dfourer/eHandPan/ESP32/doc/analyse/20250417_delai_piezzo_son/image1.jpeg

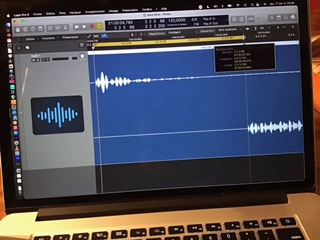
ESP32/doc/analyse/20250417_delai_piezzo_son/image1.jpeg
