dfourer/eHandPan/ESP32/doc/analyse/20260203_v2.1/20260203_123001.jpg

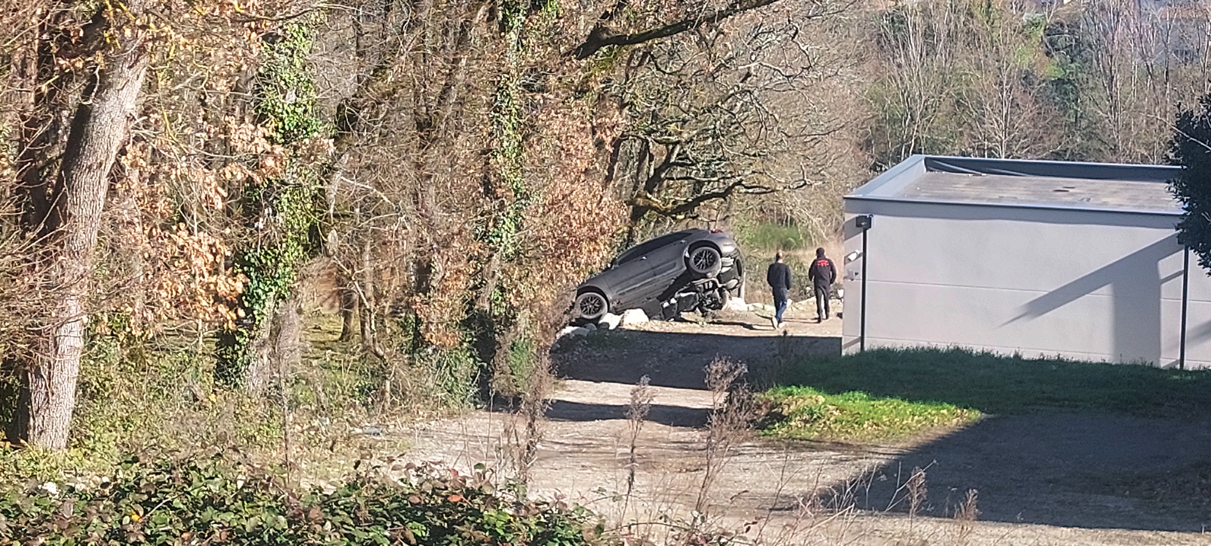
ESP32/doc/analyse/20260203_v2.1/20260203_123001.jpg
