dfourer/eHandPan/ESP32/version.md

# Liste des versions de RecupPan

| Version | Date | Comment |
| :---: | :----: | --- |
| v1.3 | xxx | Midi Send | 
| v1.2 | avril | multi-thread & détection |
| v1.1 | 03/03/25 | Retour du stage de février | 
| v1.0 | 20/02/25 | Version livrée aux 1er stagiares | 
| v0.1 | 20/12/24 | Version initiale |  

## v1.4
- joue les notes reçu en MIDI par le séquenceur + LED
- métronome staand-alone
- corrige un pb de fichier MiDI non uploadable depuis un tél GOOGLE PIXEL
- corrige un pb de bagotement à la connexion WIFI depuis un tél SAMSUNG S9

## v1.3
- envoi les notes en MIDI sur le 2ème port UDB

## v1.1 
- Page d'accueil
    - accès à l'écran de  réglages des seuils de piezzo
    - accès à l'écran de mise à jour de firmware
- Ecran Configuration : séparé 2 écrans : 
    - réglage des seuils 
    - réglage des paramètres généraux
- Réglage des seuils de piezzo 
    - Accès à la page d'accueil
    - Séparation en 2 saladiers, 
    - Possibilité d'incrémenter en +-50 depuis porta
    - Possibilité de reset tous les seuils d'un coup par saladier
- Gestion des trilles
- Demo : version Imagine en intégralité avec les trilles
- Start / stop mis sous forme de bouton image

## v1.0
- LED violette pour les frappes en mode livre (plutôt que alternance bleu/rouge)
- tempo de 500ms au démarrage pour laisser le temps aux chips de s'initialiser (limite les démarrages KO)

## v0.3
- tbd1
- tbd2

## v0.2
- tbd1
- tbd2

## v0.1
- 1ère Version draft
