dfourer/eHandPan/ESP32/doc/doc.md

# ESP32
- https://lastminuteengineers.com/esp32-basics-adc/
- https://scienceprog.com/using-current-limiting-resistors-on-avr-io-pins/
- https://espressif-docs.readthedocs-hosted.com/projects/arduino-esp32/en/latest/api/adc.html

# I2S
-   http://www.xtronical.com/I2SAudio

# MUX 
-  https://www.carnetdumaker.net/articles/utiliser-un-multiplexeur-analogique-cd4067b-avec-une-carte-arduino-genuino/
- https://deepbluembedded.com/arduino-cd74hc4067-analog-multiplexer-library-code/
- https://www.google.com/url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

# HTML
-  https://www.scriptol.fr/html5/progress.php
-  https://developer.mozilla.org/fr/docs/Web/HTML/Element/progress
- https://medium.com/@predragdavidovic10/native-dual-range-slider-html-css-javascript-91e778134816
- https://w3collective.com/double-range-slider-html-css-js/

#  MIDI
-  MIDI online parser : https://tonejs.github.io/Midi/

# piezzo
- https://forum.arduino.cc/t/piezo-on-cd74hc4067-problem/151307
- https://forum.arduino.cc/t/gate-for-piezoelectric-sensor/979572/8
- https://forums.futura-sciences.com/electronique/816828-connecter-un-piezo-de-facon-pro-a-un-p.html
- https://electronics.stackexchange.com/questions/576299/piezo-connected-to-esp32-why-doesnt-it-kill-the-input
- https://github.com/Projectslearner/esp32-piezoelectric-sensor
- https://forums.parallax.com/discussion/65336/zener-diode-for-piezo-sensor-voltage-regulator
- https://forum.arduino.cc/t/how-to-wire-a-piezo-as-an-impact-sensor/901726

# ZENER
- https://electronics.stackexchange.com/questions/595859/zener-diode-as-voltage-limiter-in-a-voltage-divider

https://musicfromouterspace.com/analogsynth_new/SOUNDLABMINISYNTH/drumtrigger/drumtrigger.html

# AOP
e 741 en a 1 aop le lm328 en a 2 et le lm324 en a 4.
Je n'ai pas mis de résistance en sortie de l'AOP , il serait préférable de mettre 1k par exemple du coté du µp.

sn74hc241n

https://github.com/Projectslearner/esp32-piezoelectric-sensor

https://ecampus.heh.be/pluginfile.php/81025/course/overviewfiles/aop_montages2020long.pdf

https://forum.allaboutcircuits.com/threads/how-to-limit-90v-from-piezo-film-sensor-to-3-3-3v.40821/

https://forum.arduino.cc/t/piezo-on-cd74hc4067-problem/151307

https://forums.parallax.com/discussion/65336/zener-diode-for-piezo-sensor-voltage-regulator

https://ecampus.heh.be/pluginfile.php/81025/course/overviewfiles/aop_montages2020long.pdf

https://forum.allaboutcircuits.com/threads/how-to-limit-90v-from-piezo-film-sensor-to-3-3-3v.40821/

https://electronics.stackexchange.com/questions/595859/zener-diode-as-voltage-limiter-in-a-voltage-divider

https://forums.futura-sciences.com/electronique/816828-connecter-un-piezo-de-facon-pro-a-un-p.html

https://musicfromouterspace.com/analogsynth_new/SOUNDLABMINISYNTH/drumtrigger/drumtrigger.html

e 741 en a 1 aop le lm328 en a 2 et le lm324 en a 4.
Je n'ai pas mis de résistance en sortie de l'AOP , il serait préférable de mettre 1k par exemple du coté du µp.

sn74hc241n

https://ecampus.heh.be/pluginfile.php/81025/course/overviewfiles/aop_montages2020long.pdf

https://forum.arduino.cc/t/how-to-wire-a-piezo-as-an-impact-sensor/901726

https://community.element14.com/technologies/test-and-measurement/b/blog/posts/piezo-disk-as-vibration-sensor-input-buffer-and-filter

# FreeROS
https://www.freertos.org/
https://docs.espressif.com/projects/esp-idf/en/v4.3-rc/esp32/api-guides/freertos-smp.html
https://esp32.com/viewtopic.php?t=12121

# GIT
git rm -rf --cached .
git add .
