dfourer/eHandPan/ESP32/doc/analyse/20260203_v2.1/v2.1.pptx

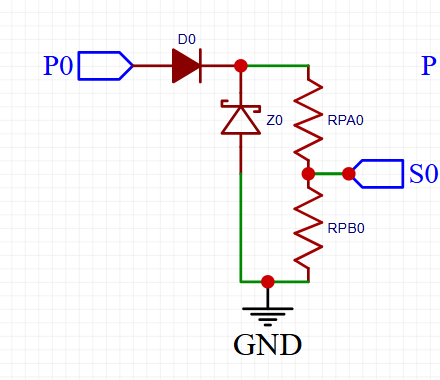
[picture p3: figure]

1N4006

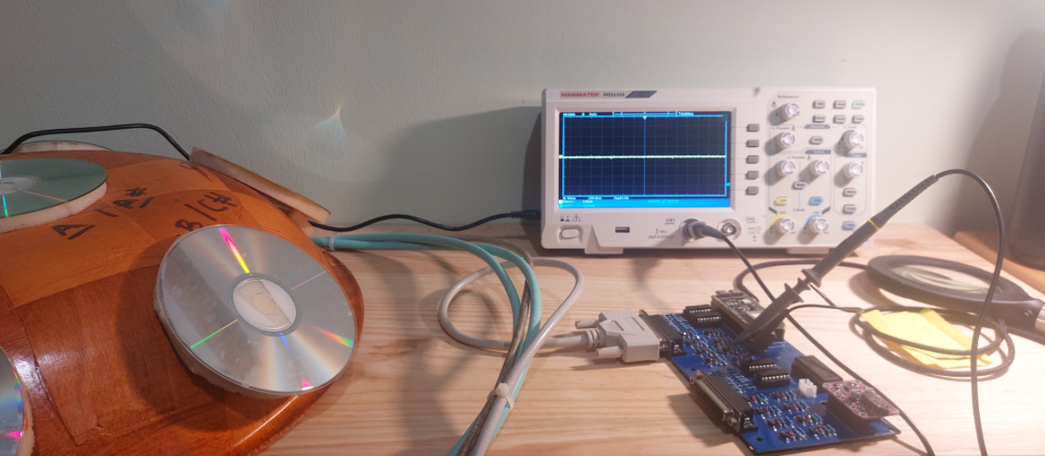
[picture p4: figure]

1Mo

1N4745A

Vz=16V

200ko

## Slide 2

Mesures à la sortie du piezzo (P0)

Signal 5-6V

2V / DIV

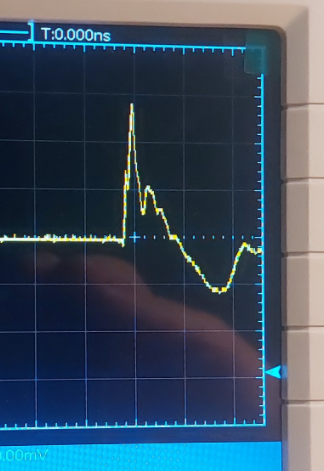
[picture p5: figure]
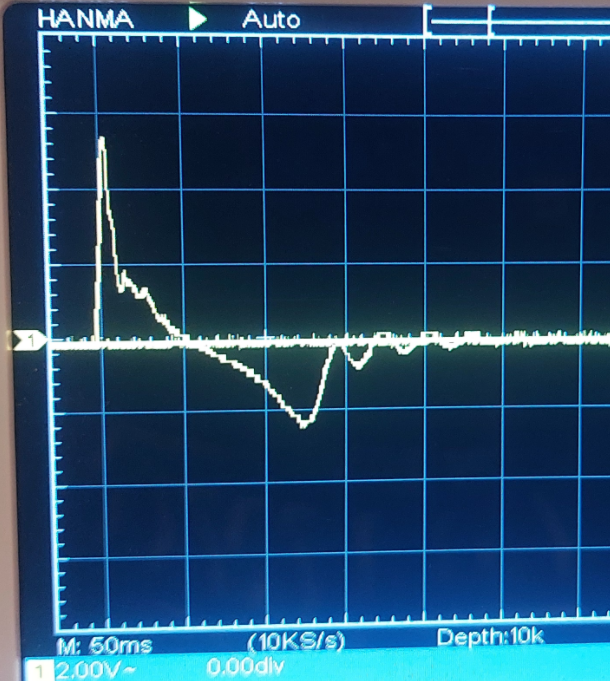
[picture p6: figure]
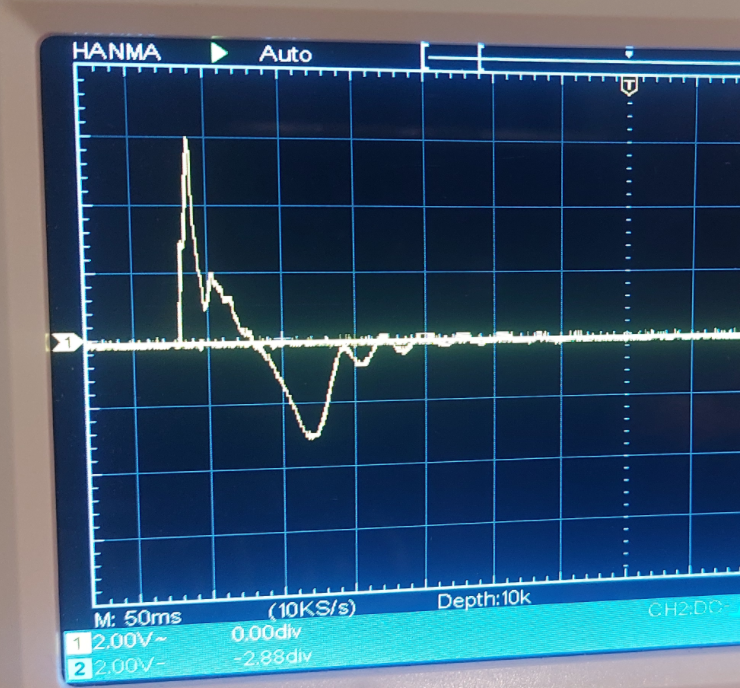
[picture p7: figure]

## Slide 3

Mesures au pont diviseur (S0)

Signal 50 – 100 mv

100 mV / DIV

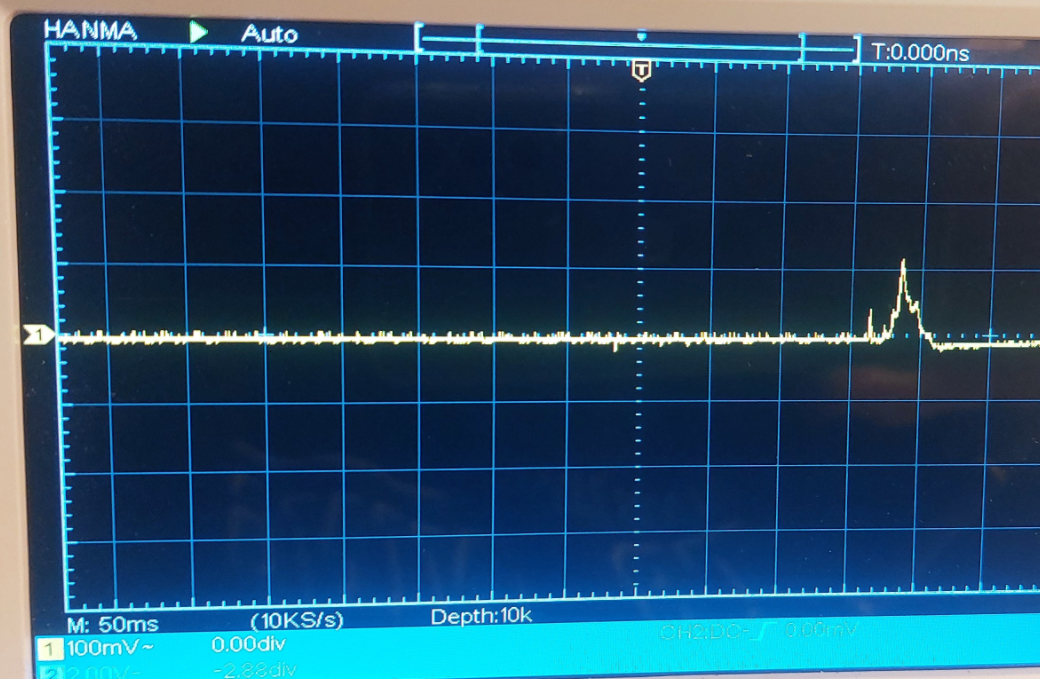
[picture p8: figure]
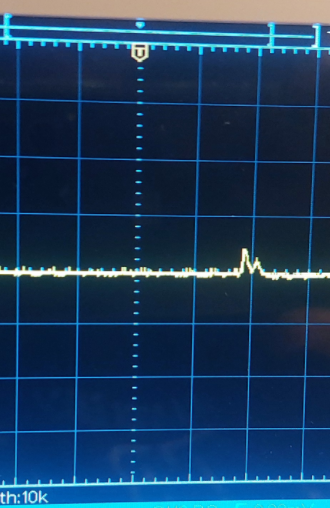
[picture p9: figure]
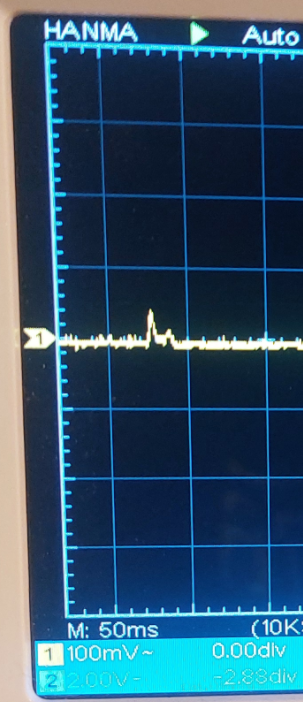
[picture p10: figure]
