dfourer/eHandPan/ESP32/doc/piezzo_analyse_09122024_2.pdf

## Tests piezzo avec R, Diode, Zener, Diode, pont diviseur

Table des matières

## Config n°1 : R

- R = 1Mo
- Pas de diode Zener , ni diode normal

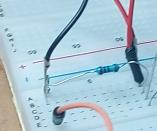
[picture p11: figure]

Config osillo : 5 V / div

E vidéo : https://youtu.be/TSOaPEjHLvE

2.5 div → ~12 V

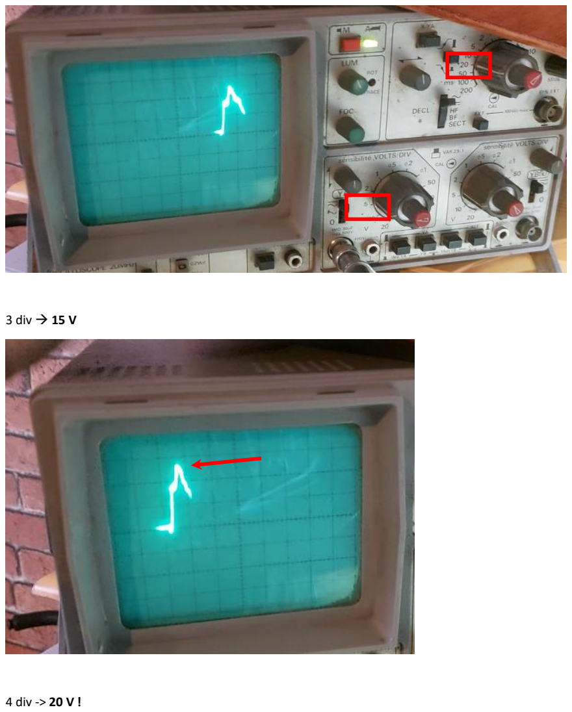
[picture p12: page 2]

3 div → 15 V

4 div -> 20 V !

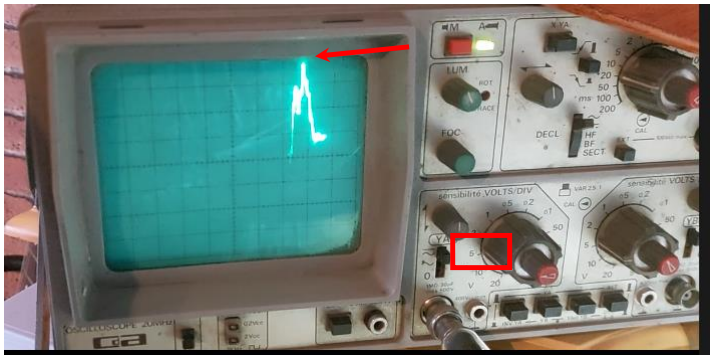
[picture p13: figure]

## Config n°2 : R + Zener

- R = Mo
- Diode Zener 3.3 V en //

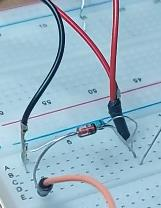
[picture p14: figure]

Vidéo : https://youtu.be/CRZy0vAVFYo

Oscillo : 1V / div

2,5 div → 2,5 V

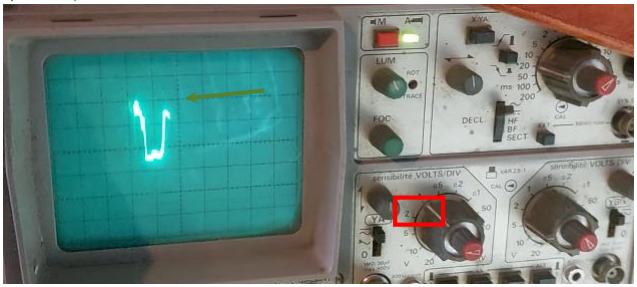
[picture p15: figure]

### 3 div → 3V

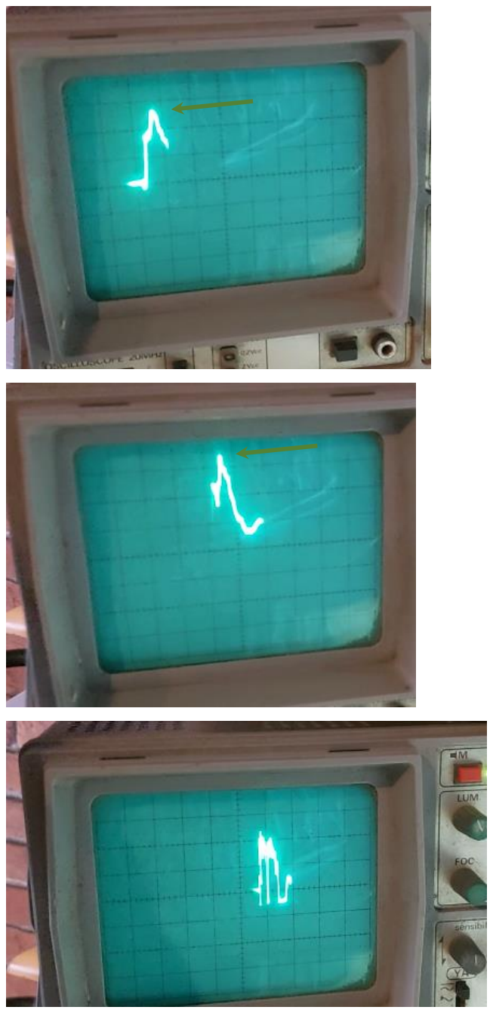
[picture p16: page 5]

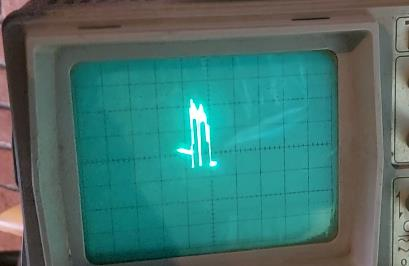
[picture p17: figure]
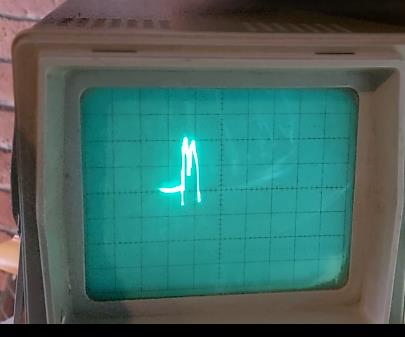
[picture p18: figure]

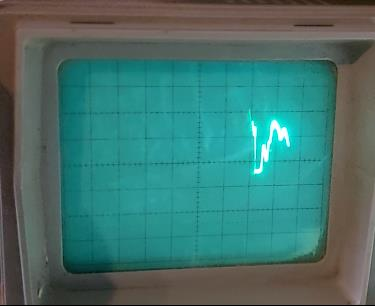
[picture p19: figure]
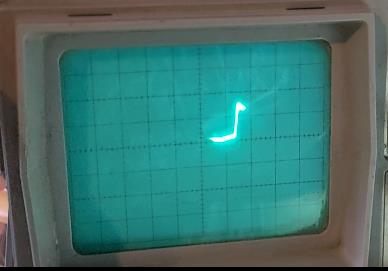
[picture p20: figure]

## Config n° 3 : R + Zener + Diode

- R = 1Mo
- Dioder Zener 3.3
- Diode 1N4148

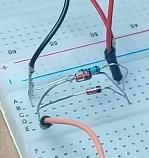
[picture p21: figure]

Vidéo https://youtu.be/frq5ACBPIEU

Oscillo : 1V / div

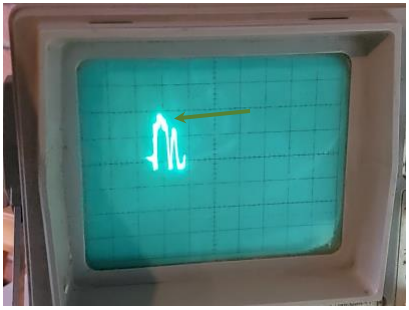
[picture p22: figure]

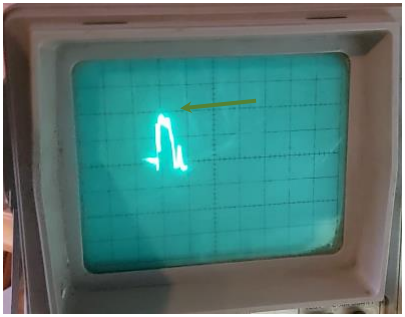
[picture p23: figure]
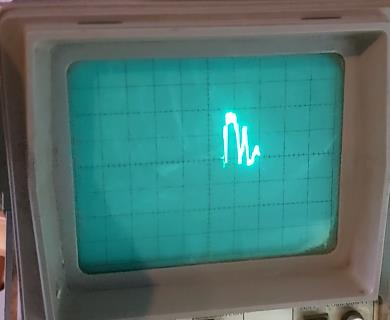
[picture p24: figure]
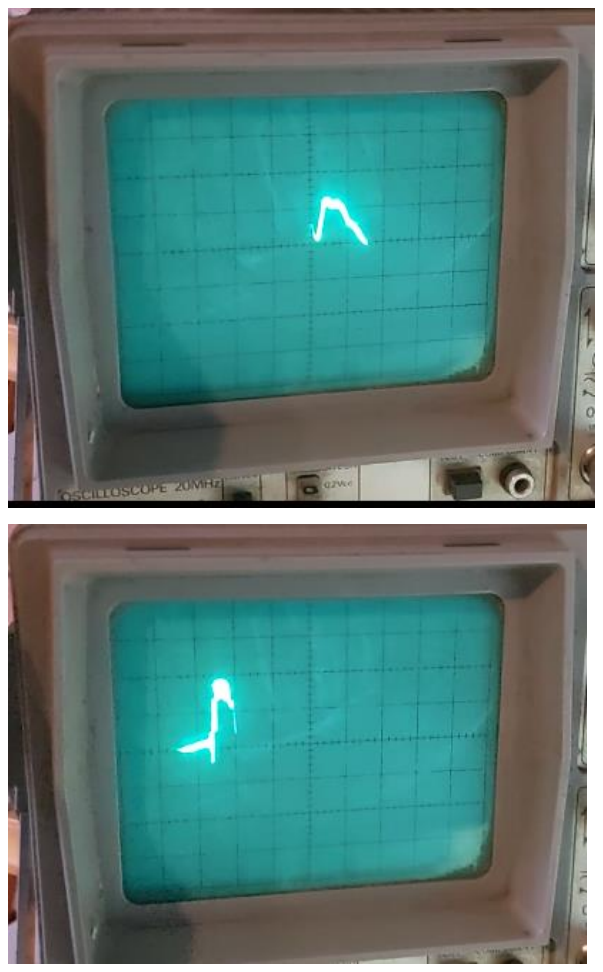
[picture p25: page 10]

## Config n°4 : pont diviseur

- Pont diviseur de résistance : 1/3
- R1 = 500 ko (oscillo
- R2 = 1Mo (capteur)
- Aucune diode

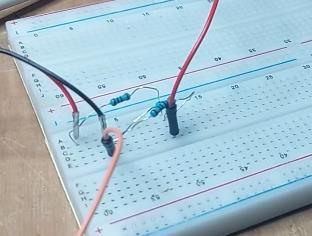
[picture p26: figure]

En vidéo : https://youtu.be/iBR8egdbkyU

Oscillo : 2V / div

Tension = 4V

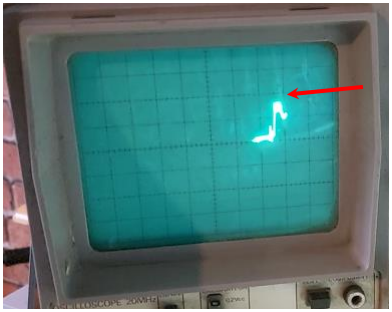
[picture p27: figure]

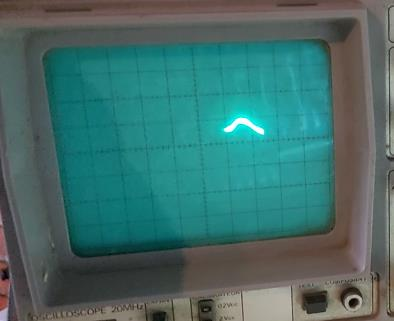
[picture p28: figure]
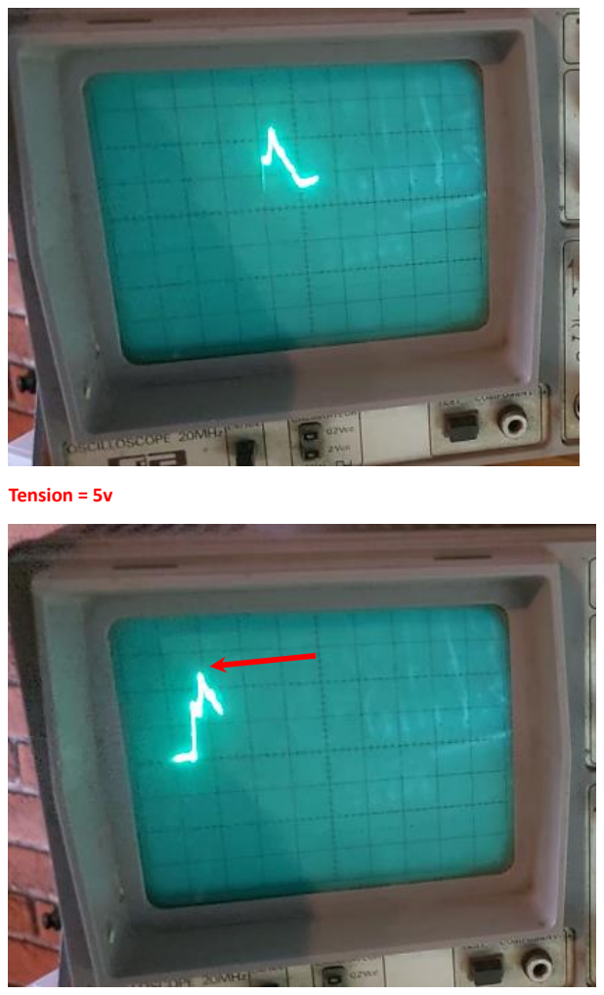
[picture p29: page 13]

Tension = 5v

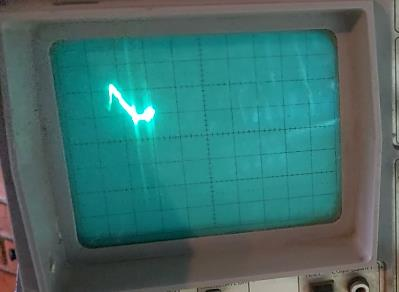
[picture p30: figure]
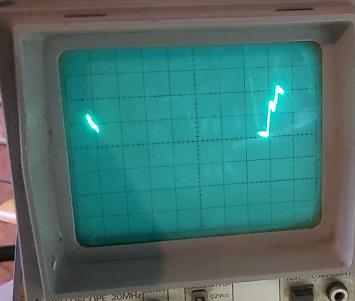
[picture p31: figure]
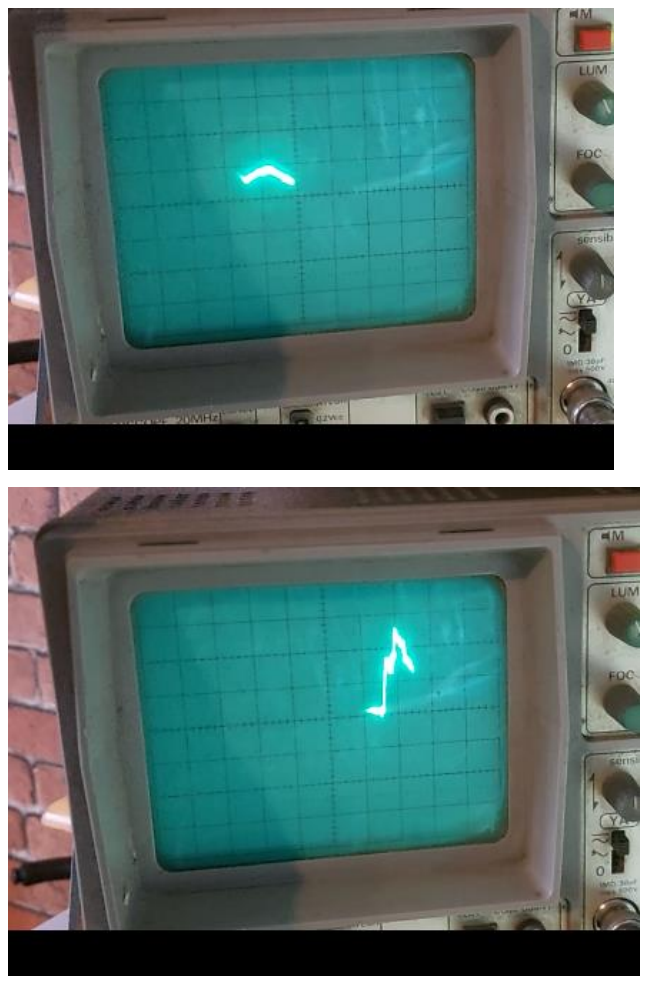
[picture p32: page 15]

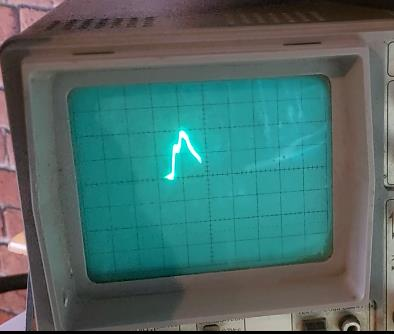
[picture p33: figure]
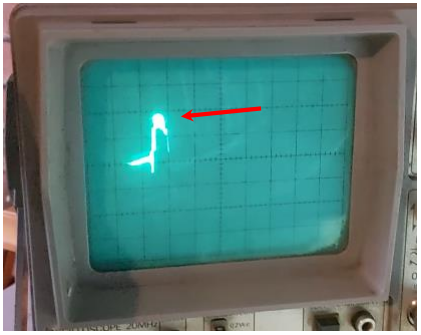
[picture p34: figure]

## Config n°5 : pont diviseur + Zener

- Pont diviseur de résistance : 1/3
- R1 = 500 ko (oscillo) + Zener
- R2 = 1Mo (capteur)

Vidéo : https://youtu.be/Sm9G2EuGxYQ
