dfourer/eHandPan/ESP32/doc/analyse/piezzo_signal_10122024.docx

# Signal du piezzo avec des frappes douces

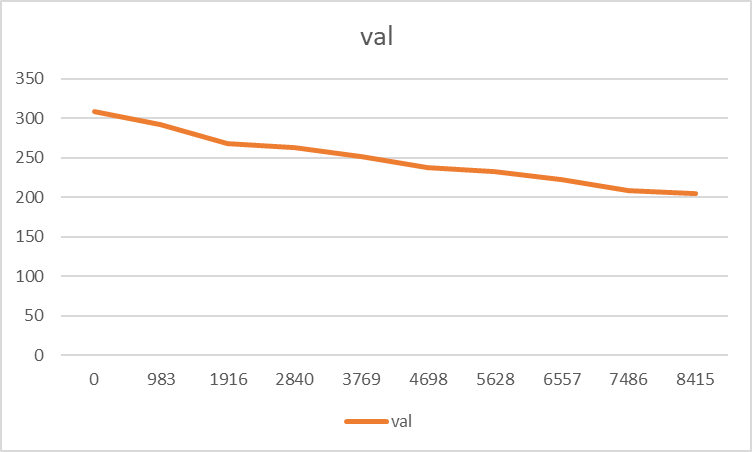
[picture p35: figure]
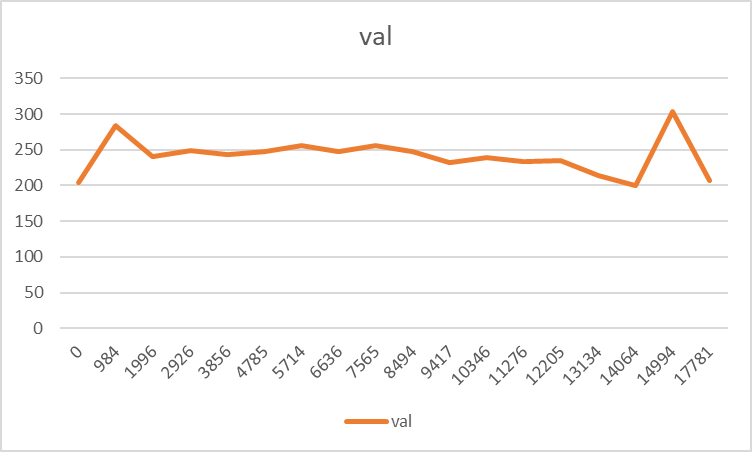
[picture p36: figure]
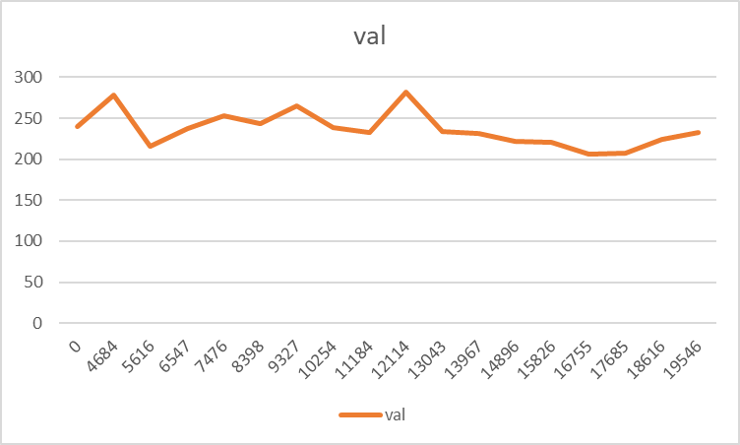
[picture p37: figure]
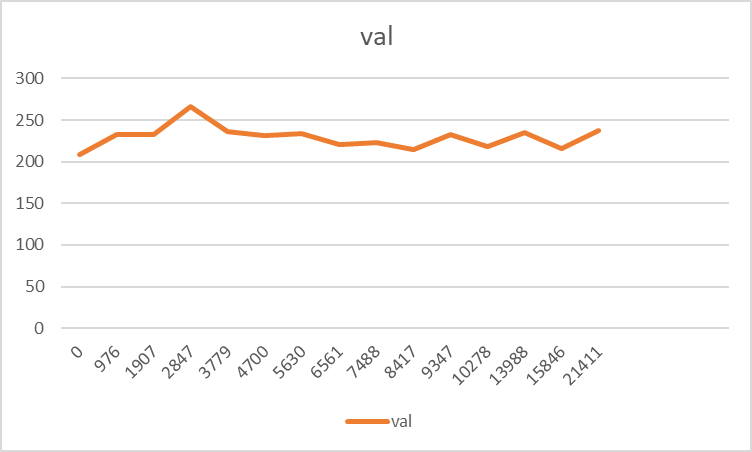
[picture p38: figure]

# Signal du piezzo avec des frappes fortes

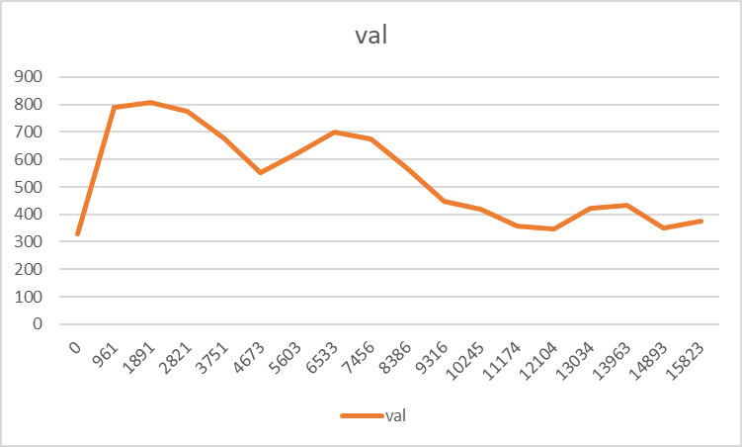
[picture p39: figure]
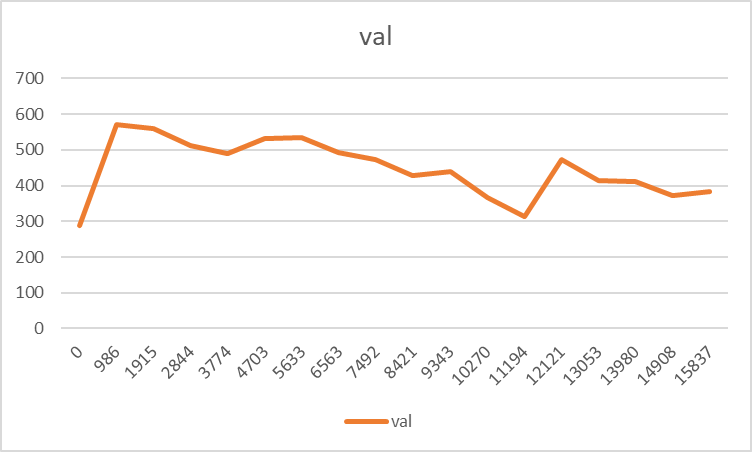
[picture p40: figure]
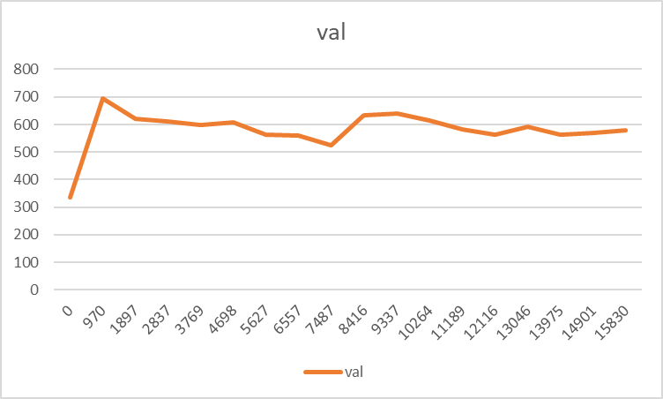
[picture p41: figure]
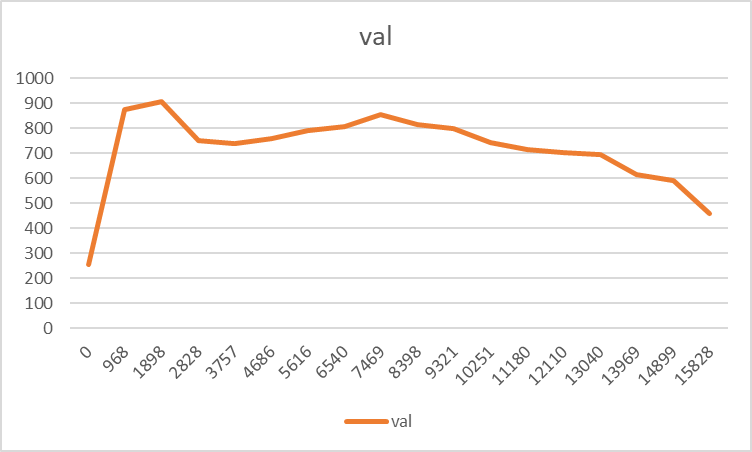
[picture p42: figure]
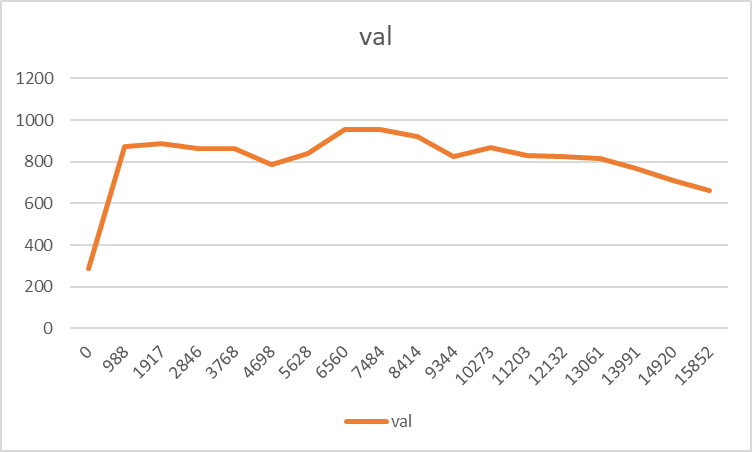
[picture p43: figure]
