dfourer/eHandPan/ESP32/boards/PCB 2026-07-28 094336.png

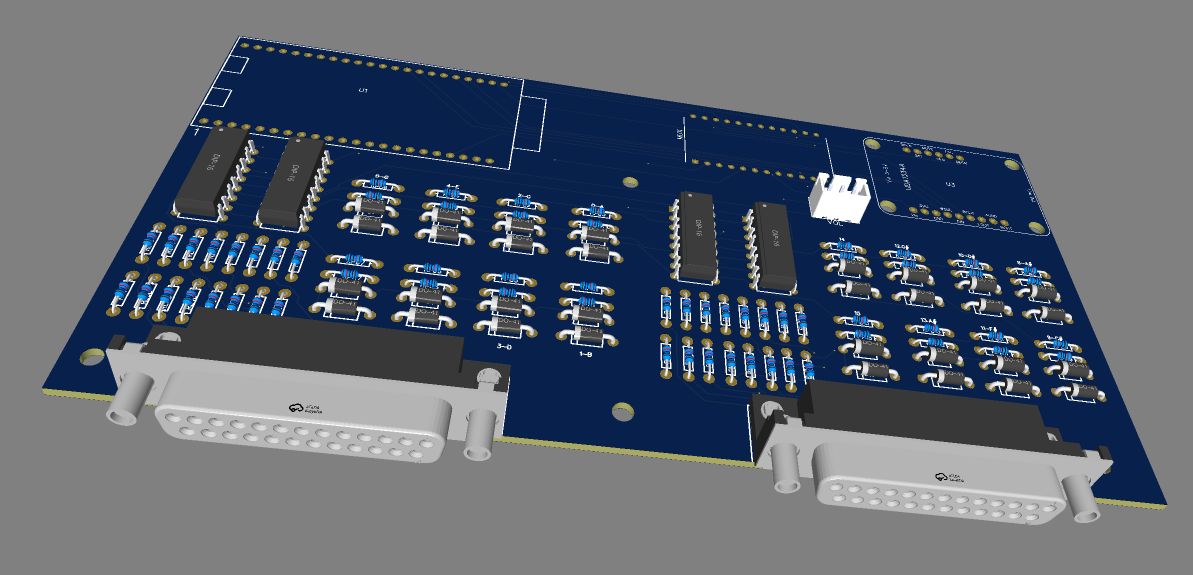
ESP32/boards/PCB 2026-07-28 094336.png
