dfourer/eHandPan/ESP32/TODO.md

# A FAIRE

# A TESTER
- [-] LED KO si 2 notes

# FAIT 0.2
- [-] plantage (reboot) parfois dans la page "/test"
- [+] volume gen non modifiable
- [+] mesure/note en court -> mesure/note en cours
- [+] Séquenceur -> Play
- [-] input slide ne fonctionne pas sous Android

# FAIT 0.1
- [TECH] T_Song * pSong à supprimer
- [TECH] Supprimer les DEBUG en mode RELEASE
- bouton pour BPM d'origine
- [TECH] mémoire MIDI free
- [-] Synchro du clic sur le temps à améliorer
- [+] Volume des WAV / Option Volume
- [+] faire un son 'tic' pour les notes non connu
- [+] Seuil de son MAX : unique (pas par piezzo)
- [+] Trace PIEZO sur le Web : page de test
- [+] Suppression check parasite
- [TECH] monitor flag dans platform.ini
- [TECH] Simplifier plateform.io
- [+] tempo de LED en mode APPRENTISSAGE
- [TECH] Entete des fichiers .h et .c
- [TECH] reboot web
- [+] attenuation ADC
- plantage en mode SEQ en fin de morceau
- En mode Apprentissage, mettre la note A, B, C plutôt que 1, 2, 
- mode WIFI STA: fichier secret
- mode test : affiche LED g/d 
- mesure de décompte
- mode apprentissage : gérer les 2 frappes
- config dans l'EEPROM
- upgrade firmware via le Web : KO
- mix wav : int64 
- page web : full largeur
- firmware + sons uploadé ? : OK 3mb avec tous les sons, vs 1mb avec un seul son
- gestion du nom PAN -> SSID
- volume : mettre un potard
- banque de sons
- frequence de loopPlayWaves()
- paramétrer le seuil de chaque note

# Nice to have
- début de la notes C2 = #define MIDI_NOTE_C2		36 // 24
- WAV avant Noël ? sinon on garde celà
- [TECH] optim web.c (param)
- mix wav :  écrêtage pour éviter disto
- favicon.ico ?

# A STATUER avec BEN
- limiter le nb de pistes
- taille max fichier MIDI
- demo MIDI 
- début de la notes C2 = #define MIDI_NOTE_C2		36 // 24

+++++++++++++++++++++ FIN ++++++++++++++++++++++++++
