dfourer/eHandPan/ESP32/boards/Kicad/eHandPan_ESP32.kicad_sch

## KiCad design ESP32/boards/Kicad/eHandPan_ESP32.kicad_sch (2026-08-16)

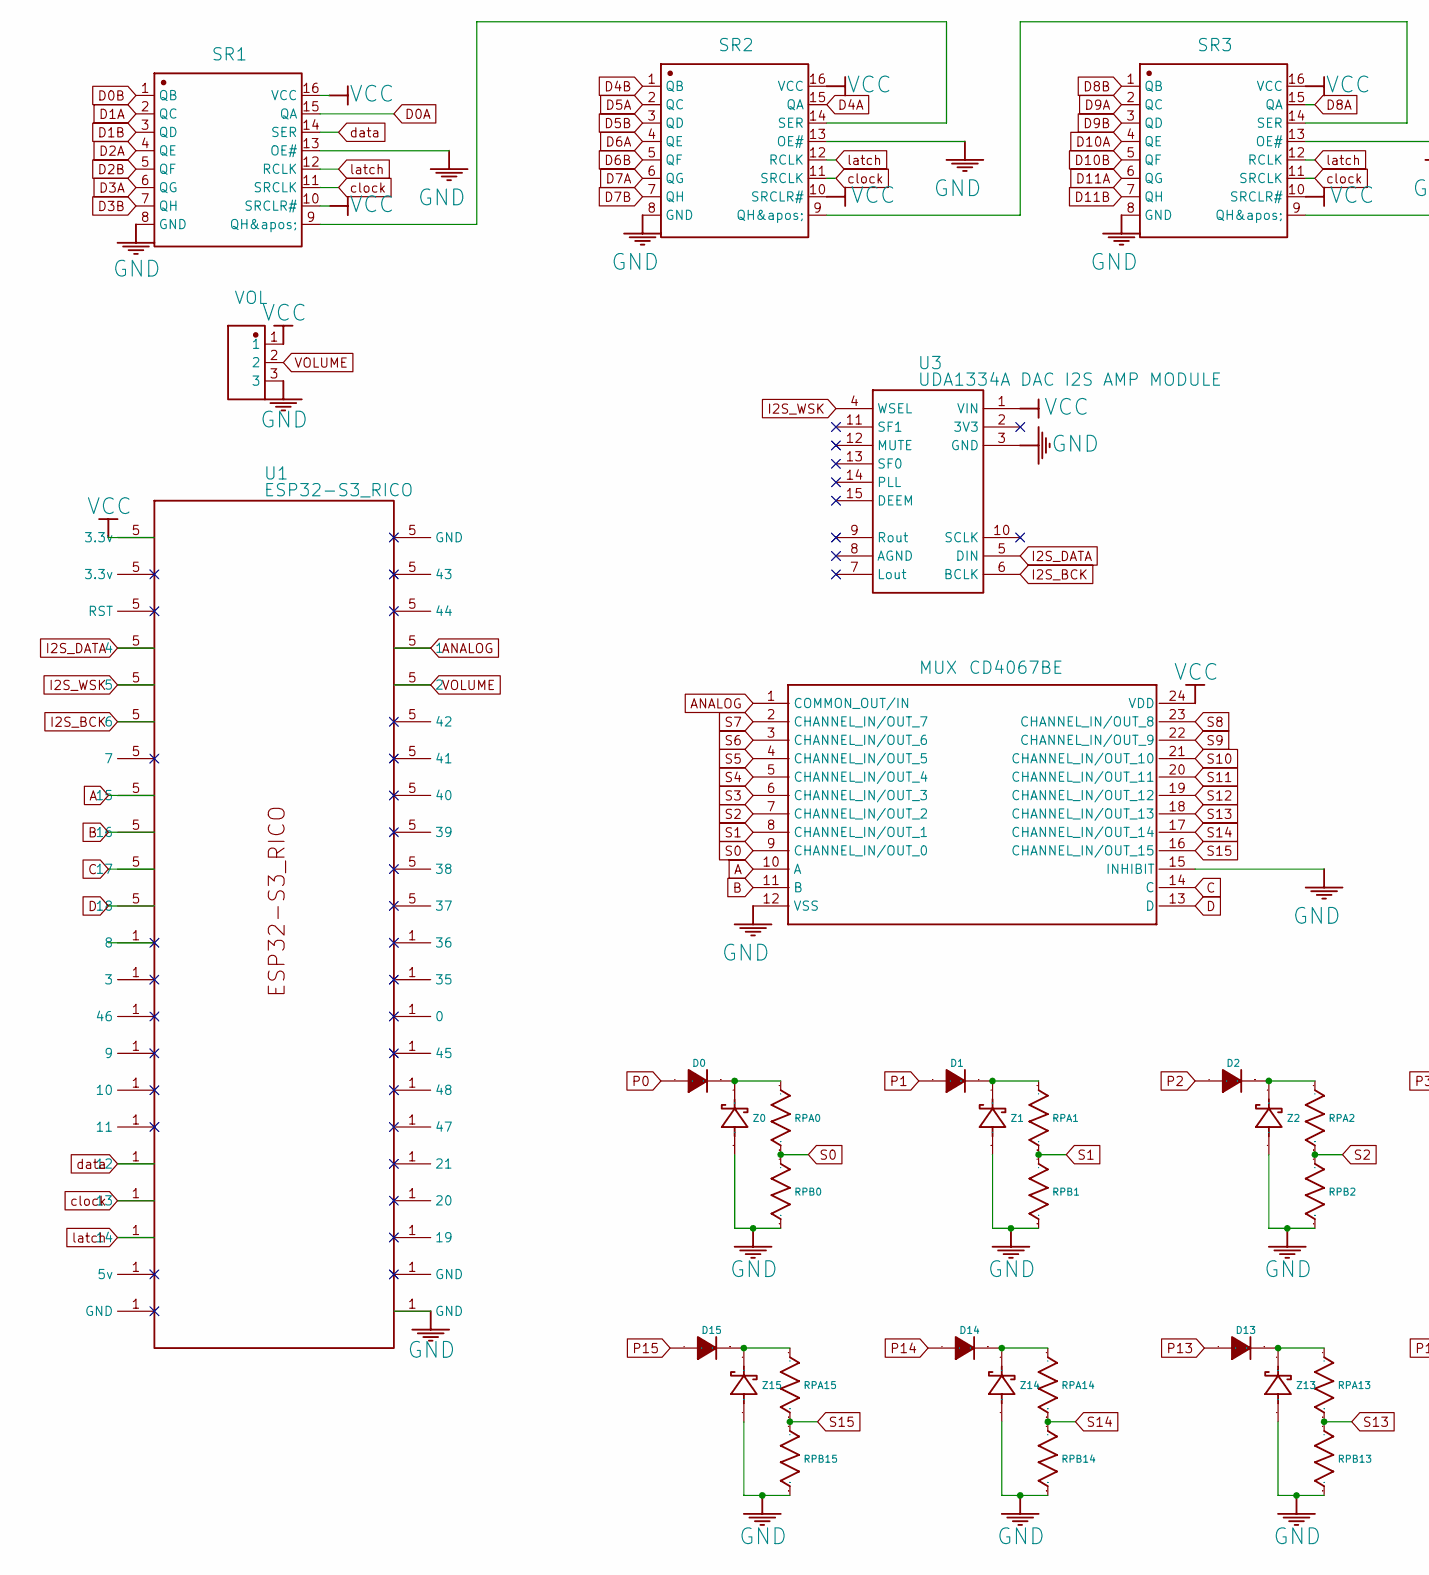
[picture p46: schematic eHandPan_ESP32.kicad_sch, part in row 1, column 1]

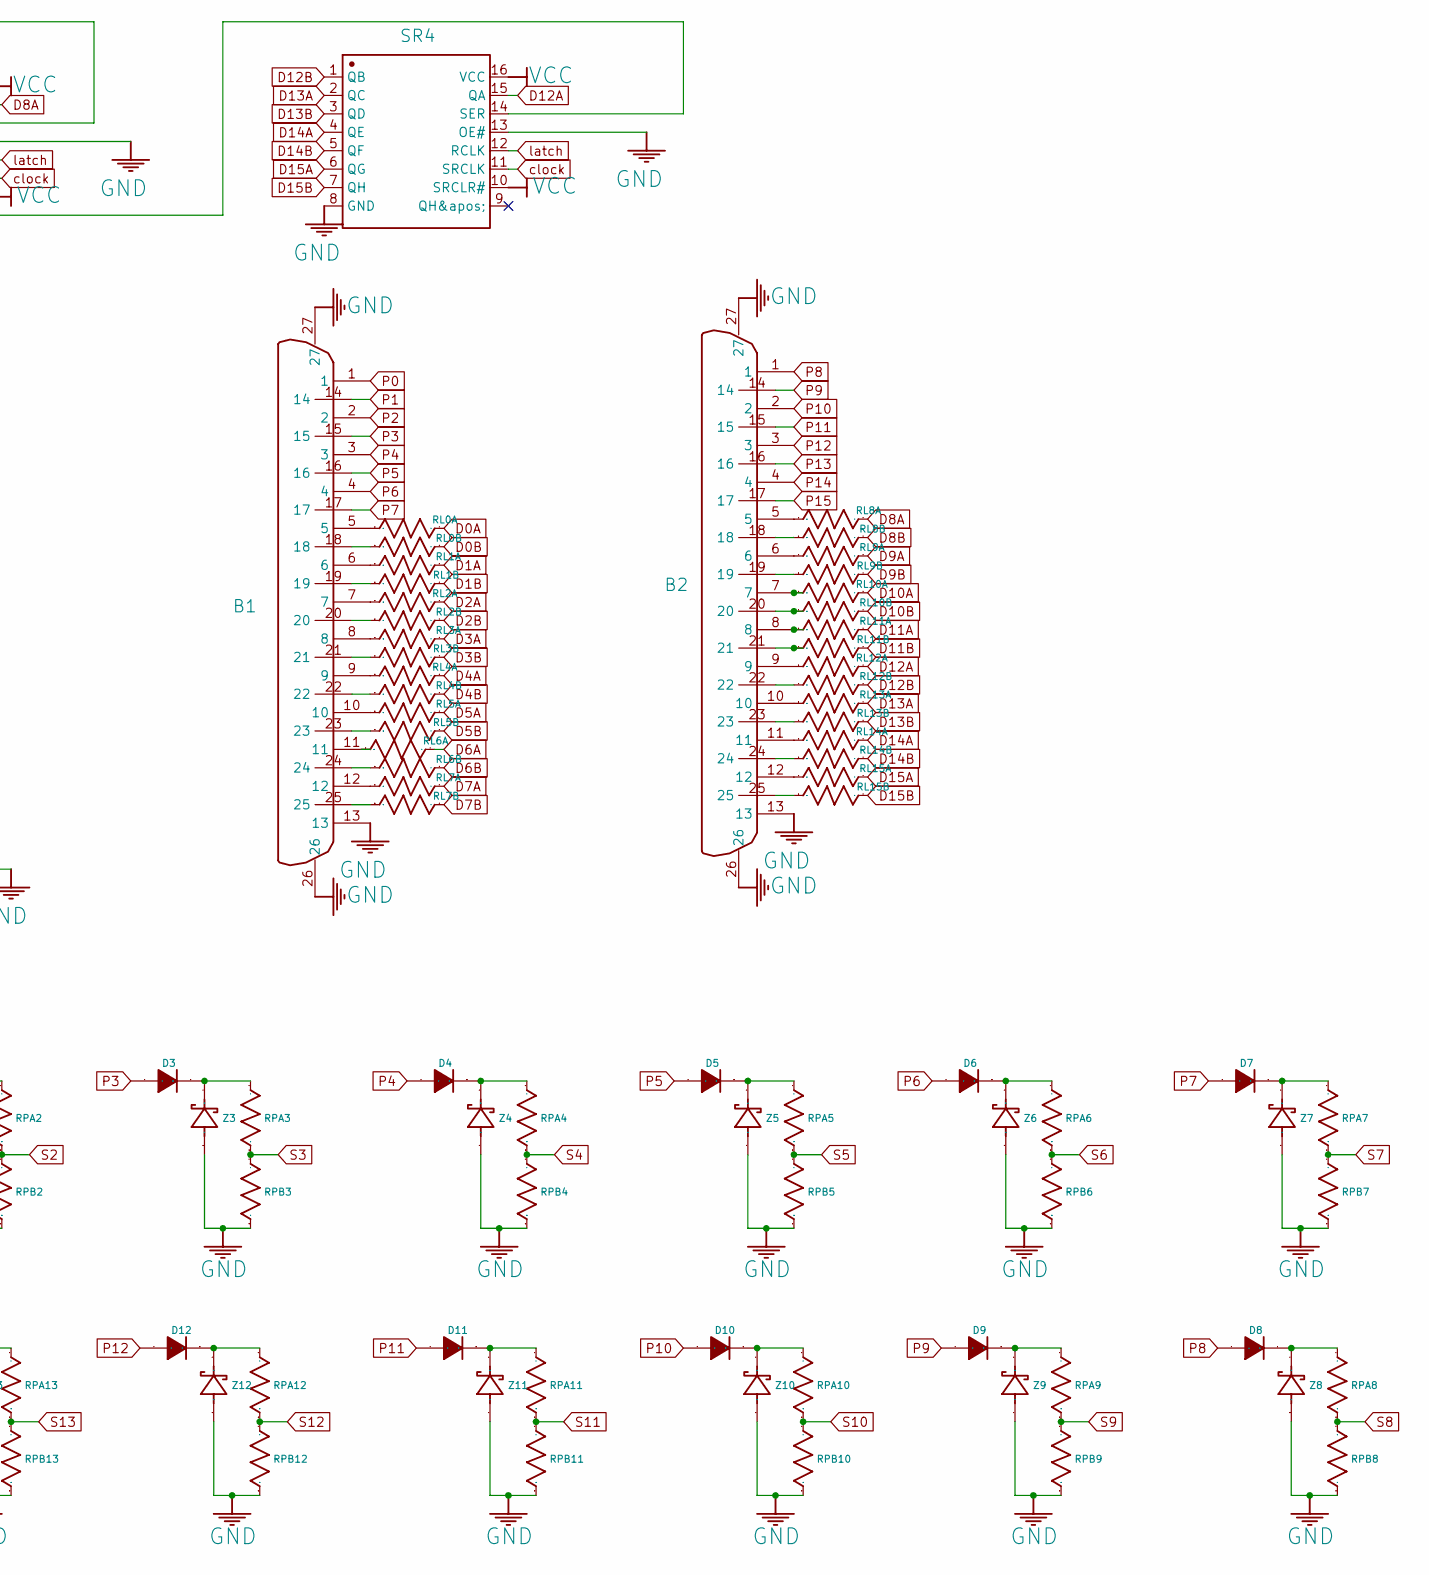
[picture p47: schematic eHandPan_ESP32.kicad_sch, part in row 1, column 2]

Parts:
B1, B2: X0325FC2W2; Manufacturer Part X0325FC2W2
D0, D1, D2, D3, D4, D5, D6, D7, D8, D9, D10, D11, D12, D13, D14, D15: 1N4006-T; Manufacturer Part 1N4006-T
MUX: CD4067BE
RL0A, RL0B, RL1A, RL1B, RL2A, RL2B, RL3A, RL3B, RL4A, RL4B, RL5A, RL5B, RL6A, RL6B, RL7A, RL7B, RL8A, RL8B, RL9A, RL9B, RL10A, RL10B, RL11A, RL11B, RL12A, RL12B, RL13A, RL13B, RL14A, RL14B, RL15A, RL15B: 4,7k
RPA0, RPA1, RPA2, RPA3, RPA4, RPA5, RPA6, RPA7, RPA8, RPA9, RPA10, RPA11, RPA12, RPA13, RPA14, RPA15: 4,7k
RPB0, RPB1, RPB2, RPB3, RPB4, RPB5, RPB6, RPB7, RPB8, RPB9, RPB10, RPB11, RPB12, RPB13, RPB14, RPB15: 4,7k
SR1, SR2, SR3, SR4: SN74HC595N; Manufacturer Part SN74HC595N
U1: ESP32-S3_RICO
U3: UDA1334A DAC I2S AMP MODULE
VOL: XH_2.54_3P; Manufacturer Part XH_2.54_3P
Z0, Z1, Z2, Z3, Z4, Z5, Z6, Z7, Z8, Z9, Z10, Z11, Z12, Z13, Z14, Z15: JANTX1N6462.TR; Manufacturer Part JANTX1N6462.TR

Connections:
A: MUX.10 (A), U1.5 (3.3v)
ANALOG: MUX.1 (COMMON_OUT/IN), U1.5 (3.3v)
B: MUX.11 (B), U1.5 (3.3v)
C: MUX.14 (C), U1.5 (3.3v)
D: MUX.13 (D), U1.5 (3.3v)
D0A: RL0A.2, SR1.15 (QA)
D0B: RL0B.2, SR1.1 (QB)
D1A: RL1A.2, SR1.2 (QC)
D1B: RL1B.2, SR1.3 (QD)
D2A: RL2A.2, SR1.4 (QE)
D2B: RL2B.2, SR1.5 (QF)
D3A: RL3A.2, SR1.6 (QG)
D3B: RL3B.2, SR1.7 (QH)
D4A: RL4A.2, SR2.15 (QA)
D4B: RL4B.2, SR2.1 (QB)
D5A: RL5A.2, SR2.2 (QC)
D5B: RL5B.2, SR2.3 (QD)
D6A: RL6A.2, SR2.4 (QE)
D6B: RL6B.2, SR2.5 (QF)
D7A: RL7A.2, SR2.6 (QG)
D7B: RL7B.2, SR2.7 (QH)
D8A: RL8A.2, SR3.15 (QA)
D8B: RL8B.2, SR3.1 (QB)
D9A: RL9A.2, SR3.2 (QC)
D9B: RL9B.2, SR3.3 (QD)
D10A: RL10A.2, SR3.4 (QE)
D10B: RL10B.2, SR3.5 (QF)
D11A: RL11A.2, SR3.6 (QG)
D11B: RL11B.2, SR3.7 (QH)
D12A: RL12A.2, SR4.15 (QA)
D12B: RL12B.2, SR4.1 (QB)
D13A: RL13A.2, SR4.2 (QC)
D13B: RL13B.2, SR4.3 (QD)
D14A: RL14A.2, SR4.4 (QE)
D14B: RL14B.2, SR4.5 (QF)
D15A: RL15A.2, SR4.6 (QG)
D15B: RL15B.2, SR4.7 (QH)
I2S_BCK: U1.5 (3.3v), U3.6 (BCLK)
I2S_DATA: U1.5 (3.3v), U3.5 (DIN)
I2S_WSK: U1.5 (3.3v), U3.4 (WSEL)
unnamed: B1.5, RL0A.1
unnamed: B1.6, RL1A.1
unnamed: B1.7, RL2A.1
unnamed: B1.8, RL3A.1
unnamed: B1.9, RL4A.1
unnamed: B1.10, RL5A.1
unnamed: B1.11, RL6A.1
unnamed: B1.12, RL7A.1
unnamed: B1.18, RL0B.1
unnamed: B1.19, RL1B.1
unnamed: B1.20, RL2B.1
unnamed: B1.21, RL3B.1
unnamed: B1.22, RL4B.1
unnamed: B1.23, RL5B.1
unnamed: B1.24, RL6B.1
unnamed: B1.25, RL7B.1
unnamed: B2.5, RL8A.1
unnamed: B2.6, RL9A.1
unnamed: B2.7, RL10A.1
unnamed: B2.8, RL11A.1
unnamed: B2.9, RL12A.1
unnamed: B2.10, RL13A.1
unnamed: B2.11, RL14A.1
unnamed: B2.12, RL15A.1
unnamed: B2.18, RL8B.1
unnamed: B2.19, RL9B.1
unnamed: B2.20, RL10B.1
unnamed: B2.21, RL11B.1
unnamed: B2.22, RL12B.1
unnamed: B2.23, RL13B.1
unnamed: B2.24, RL14B.1
unnamed: B2.25, RL15B.1
unnamed: D0.1 (K), RPA0.2, Z0.2 (K)
unnamed: D1.1 (K), RPA1.2, Z1.2 (K)
unnamed: D2.1 (K), RPA2.2, Z2.2 (K)
unnamed: D3.1 (K), RPA3.2, Z3.2 (K)
unnamed: D4.1 (K), RPA4.2, Z4.2 (K)
unnamed: D5.1 (K), RPA5.2, Z5.2 (K)
unnamed: D6.1 (K), RPA6.2, Z6.2 (K)
unnamed: D7.1 (K), RPA7.2, Z7.2 (K)
unnamed: D8.1 (K), RPA8.2, Z8.2 (K)
unnamed: D9.1 (K), RPA9.2, Z9.2 (K)
unnamed: D10.1 (K), RPA10.2, Z10.2 (K)
unnamed: D11.1 (K), RPA11.2, Z11.2 (K)
unnamed: D12.1 (K), RPA12.2, Z12.2 (K)
unnamed: D13.1 (K), RPA13.2, Z13.2 (K)
unnamed: D14.1 (K), RPA14.2, Z14.2 (K)
unnamed: D15.1 (K), RPA15.2, Z15.2 (K)
unnamed: RPB0.1, Z0.1 (A)
unnamed: RPB1.1, Z1.1 (A)
unnamed: RPB2.1, Z2.1 (A)
unnamed: RPB3.1, Z3.1 (A)
unnamed: RPB4.1, Z4.1 (A)
unnamed: RPB5.1, Z5.1 (A)
unnamed: RPB6.1, Z6.1 (A)
unnamed: RPB7.1, Z7.1 (A)
unnamed: RPB8.1, Z8.1 (A)
unnamed: RPB9.1, Z9.1 (A)
unnamed: RPB10.1, Z10.1 (A)
unnamed: RPB11.1, Z11.1 (A)
unnamed: RPB12.1, Z12.1 (A)
unnamed: RPB13.1, Z13.1 (A)
unnamed: RPB14.1, Z14.1 (A)
unnamed: RPB15.1, Z15.1 (A)
unnamed: SR1.9 (QH&apos;), SR2.14 (SER)
unnamed: SR2.9 (QH&apos;), SR3.14 (SER)
unnamed: SR3.9 (QH&apos;), SR4.14 (SER)
P0: B1.1, D0.2 (A)
P1: B1.14, D1.2 (A)
P2: B1.2, D2.2 (A)
P3: B1.15, D3.2 (A)
P4: B1.3, D4.2 (A)
P5: B1.16, D5.2 (A)
P6: B1.4, D6.2 (A)
P7: B1.17, D7.2 (A)
P8: B2.1, D8.2 (A)
P9: B2.14, D9.2 (A)
P10: B2.2, D10.2 (A)
P11: B2.15, D11.2 (A)
P12: B2.3, D12.2 (A)
P13: B2.16, D13.2 (A)
P14: B2.4, D14.2 (A)
P15: B2.17, D15.2 (A)
S0: MUX.9 (CHANNEL_IN/OUT_0), RPA0.1, RPB0.2
S1: MUX.8 (CHANNEL_IN/OUT_1), RPA1.1, RPB1.2
S2: MUX.7 (CHANNEL_IN/OUT_2), RPA2.1, RPB2.2
S3: MUX.6 (CHANNEL_IN/OUT_3), RPA3.1, RPB3.2
S4: MUX.5 (CHANNEL_IN/OUT_4), RPA4.1, RPB4.2
S5: MUX.4 (CHANNEL_IN/OUT_5), RPA5.1, RPB5.2
S6: MUX.3 (CHANNEL_IN/OUT_6), RPA6.1, RPB6.2
S7: MUX.2 (CHANNEL_IN/OUT_7), RPA7.1, RPB7.2
S8: MUX.23 (CHANNEL_IN/OUT_8), RPA8.1, RPB8.2
S9: MUX.22 (CHANNEL_IN/OUT_9), RPA9.1, RPB9.2
S10: MUX.21 (CHANNEL_IN/OUT_10), RPA10.1, RPB10.2
S11: MUX.20 (CHANNEL_IN/OUT_11), RPA11.1, RPB11.2
S12: MUX.19 (CHANNEL_IN/OUT_12), RPA12.1, RPB12.2
S13: MUX.18 (CHANNEL_IN/OUT_13), RPA13.1, RPB13.2
S14: MUX.17 (CHANNEL_IN/OUT_14), RPA14.1, RPB14.2
S15: MUX.16 (CHANNEL_IN/OUT_15), RPA15.1, RPB15.2
VOLUME: U1.5 (3.3v), VOL.2
clock: SR1.11 (SRCLK), SR2.11 (SRCLK), SR3.11 (SRCLK), SR4.11 (SRCLK), U1.1 (8)
data: SR1.14 (SER), U1.1 (8)
latch: SR1.12 (RCLK), SR2.12 (RCLK), SR3.12 (RCLK), SR4.12 (RCLK), U1.1 (8)
