dfourer/eHandPan/ESP32/src/mididemo.cpp

//=======================================================================================================================
///
/// @file main.cpp
/// 
/// Demo MIDI
//   Convert with https://notisrac.github.io/FileToCArray/
/// 
/// @author Eric GENOTELLE
/// @date 2024
/// 
///=======================================================================================================================

#include <arduino.h>
#include "global.h"


// IMAGINE

// array size is 7880
const BYTE demoMidi[]  = {
  0x4d, 0x54, 0x68, 0x64, 0x00, 0x00, 0x00, 0x06, 0x00, 0x00, 0x00, 0x01, 0x01, 0xe0, 0x4d, 0x54, 
  0x72, 0x6b, 0x00, 0x00, 0x1e, 0xb2, 0x00, 0xff, 0x20, 0x01, 0x00, 0x00, 0xff, 0x03, 0x16, 0x43, 
  0x6c, 0x61, 0x73, 0x73, 0x69, 0x63, 0x20, 0x45, 0x6c, 0x65, 0x63, 0x74, 0x72, 0x69, 0x63, 0x20, 
  0x50, 0x69, 0x61, 0x6e, 0x6f, 0x00, 0xff, 0x04, 0x0a, 0x53, 0x70, 0x61, 0x63, 0x65, 0x20, 0x44, 
  0x72, 0x75, 0x6d, 0x00, 0xff, 0x58, 0x04, 0x04, 0x02, 0x18, 0x08, 0x00, 0xff, 0x59, 0x02, 0x00, 
  0x00, 0x00, 0xff, 0x54, 0x05, 0x21, 0x00, 0x00, 0x00, 0x00, 0x00, 0xff, 0x51, 0x03, 0x0e, 0xc4, 
  0x3e, 0x00, 0xff, 0x06, 0x05, 0x49, 0x6e, 0x74, 0x72, 0x6f, 0x00, 0xff, 0x05, 0x01, 0x31, 0x00, 
  0x90, 0x40, 0x50, 0x00, 0x43, 0x4f, 0x81, 0x70, 0xff, 0x05, 0x01, 0x26, 0x00, 0x80, 0x40, 0x40, 
  0x00, 0x43, 0x40, 0x00, 0x90, 0x3c, 0x50, 0x81, 0x70, 0xff, 0x05, 0x01, 0x32, 0x00, 0x80, 0x3c, 
  0x40, 0x00, 0x90, 0x40, 0x50, 0x00, 0x43, 0x4f, 0x81, 0x70, 0xff, 0x05, 0x01, 0x26, 0x00, 0x80, 
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
  0x00, 0x90, 0x3c, 0x50, 0x81, 0x70, 0xff, 0x05, 0x01, 0x34, 0x00, 0x80, 0x3c, 0x40, 0x00, 0x90, 
  0x39, 0x50, 0x78, 0x80, 0x39, 0x40, 0x00, 0x90, 0x3a, 0x4f, 0x78, 0xff, 0x05, 0x01, 0x26, 0x00, 
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
};


size_t demoMidiLen = sizeof(demoMidi);
