dfourer/eHandPan/ESP32/src/config_secret.h

///=======================================================================================================================
///
/// @file config_secret.cpp
/// 
/// Configuration file with secret information
/// 
/// @author Eric GENOTELLE
/// @date 2024
///
///=======================================================================================================================

#pragma once


#define PAN_WIFI_STA_PASSWORD       "tobechanged"         //@brief Password related to SSID in WIFI STA mode
