dfourer/eHandPan/ESP32/src/web.h

//=======================================================================================================================
//
/// @file web.cpp
/// 
/// Header file for web management: Handle web pages 
/// 
/// @author Eric GENOTELLE
/// @date 2024
///
//=======================================================================================================================

#pragma once

void setupWeb();
void loopWeb();
