dfourer/eHandPan/(commit log)

2026-08-07 clean and commented arduino code
2026-08-16 kicad schematic
