dfourer/eHandPan/(notices)

Notices in the files:
ESP32/src/midiinfo.h:
modify it under the terms of the GNU General Public License as
published by the Free Software Foundation; either version 2 of
the License,or (at your option) any later version.
